wenzel-lab/SiMoRa-microscope/docs/laser "clamshell" part1.png

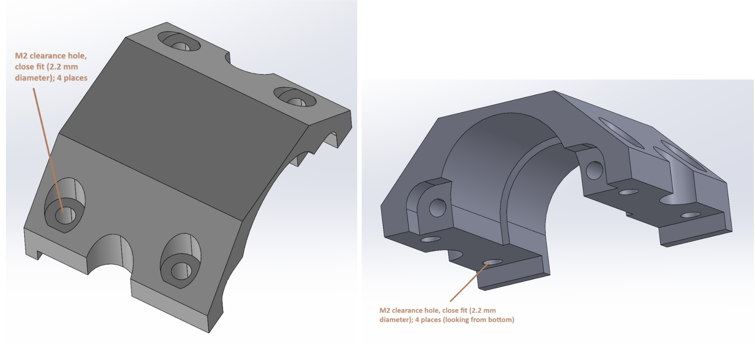
docs/laser "clamshell" part1.png
