wenzel-lab/SiMoRa-microscope/docs/laser "clamshell" part2.png

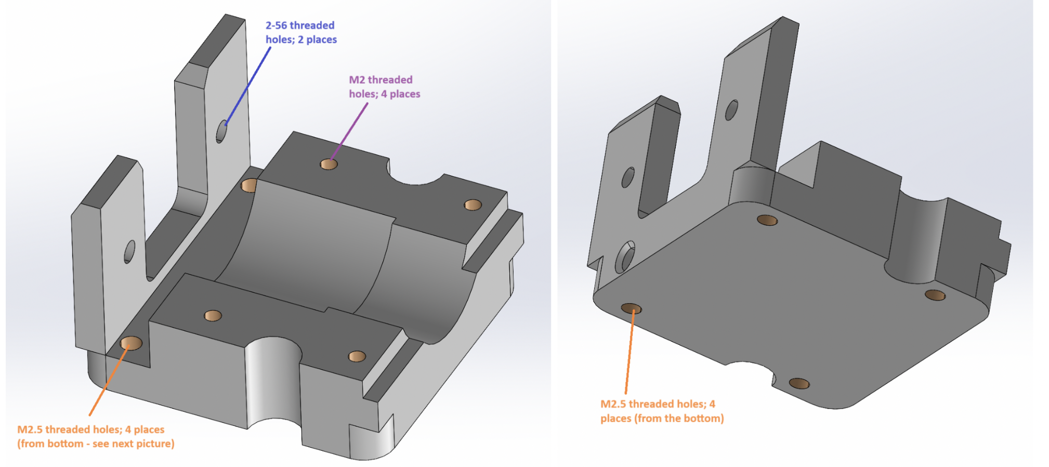
docs/laser "clamshell" part2.png
