wenzel-lab/SiMoRa-microscope/images/fan-controller-board.jpeg

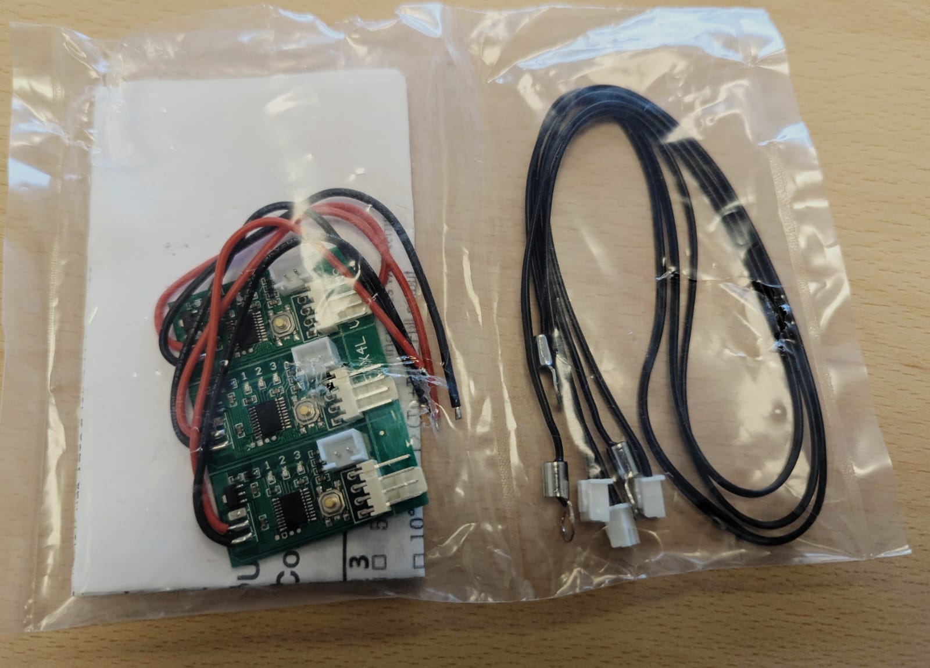
images/fan-controller-board.jpeg
