wenzel-lab/SiMoRa-microscope/images/filter_orientations.jpeg

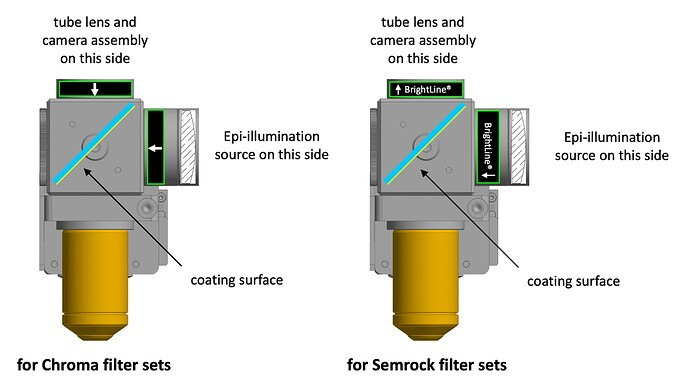
images/filter_orientations.jpeg
