wenzel-lab/SiMoRa-microscope/images/SQUID-4x5chanel-fluorescence-microscope V2.jpeg

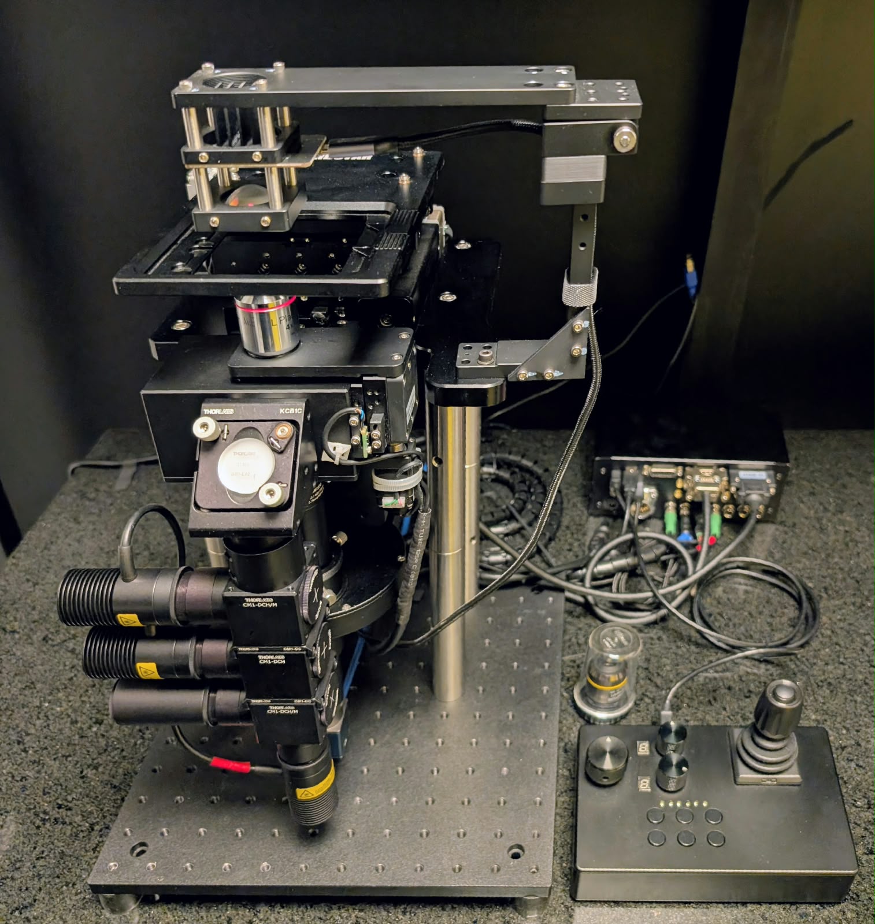
images/SQUID-4x5chanel-fluorescence-microscope V2.jpeg
