wenzel-lab/SiMoRa-microscope/docs/fan_controller_instructions.pdf

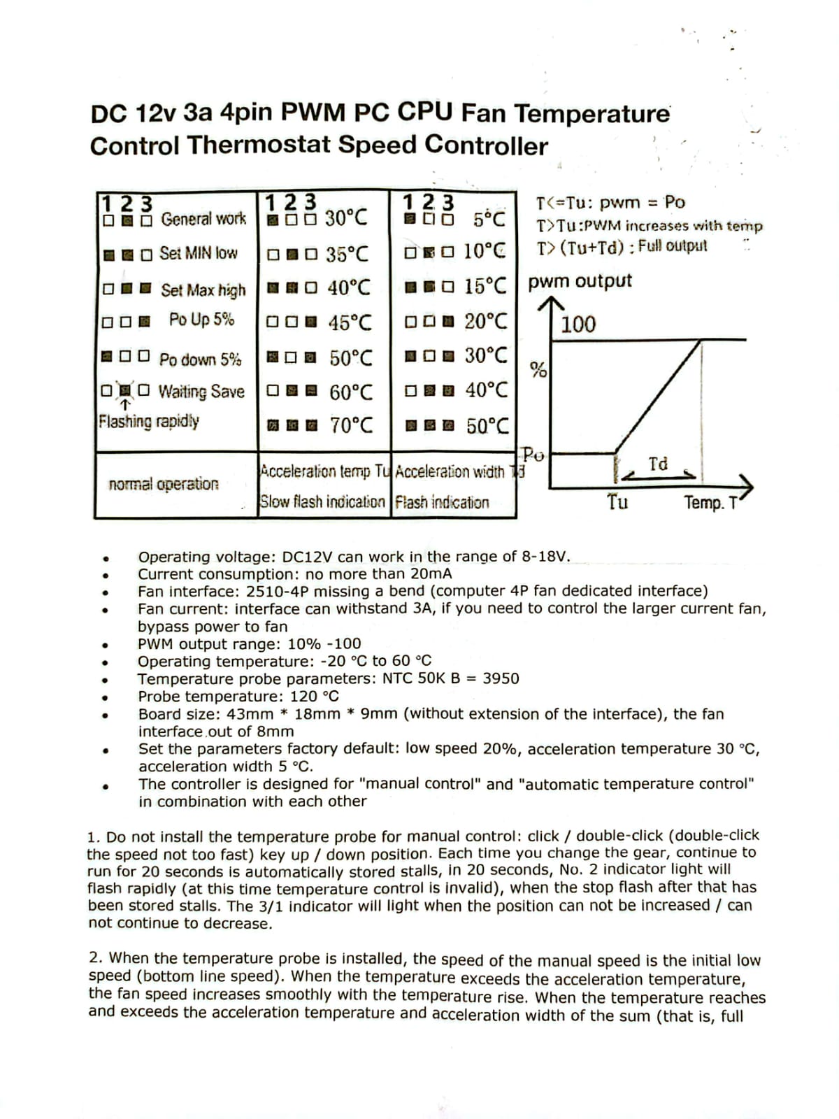
[picture p14: page 1]
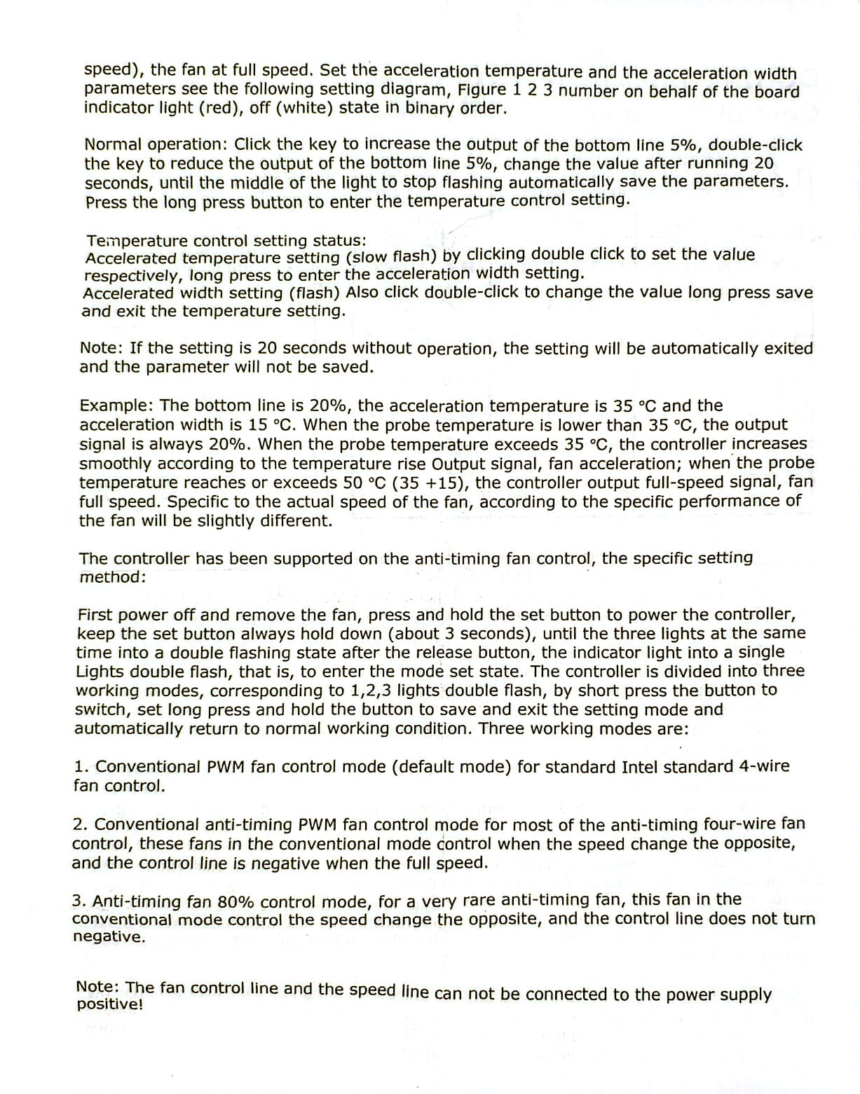
[picture p15: page 2]
