wenzel-lab/SiMoRa-microscope/docs/Squid_controller PCB.pdf

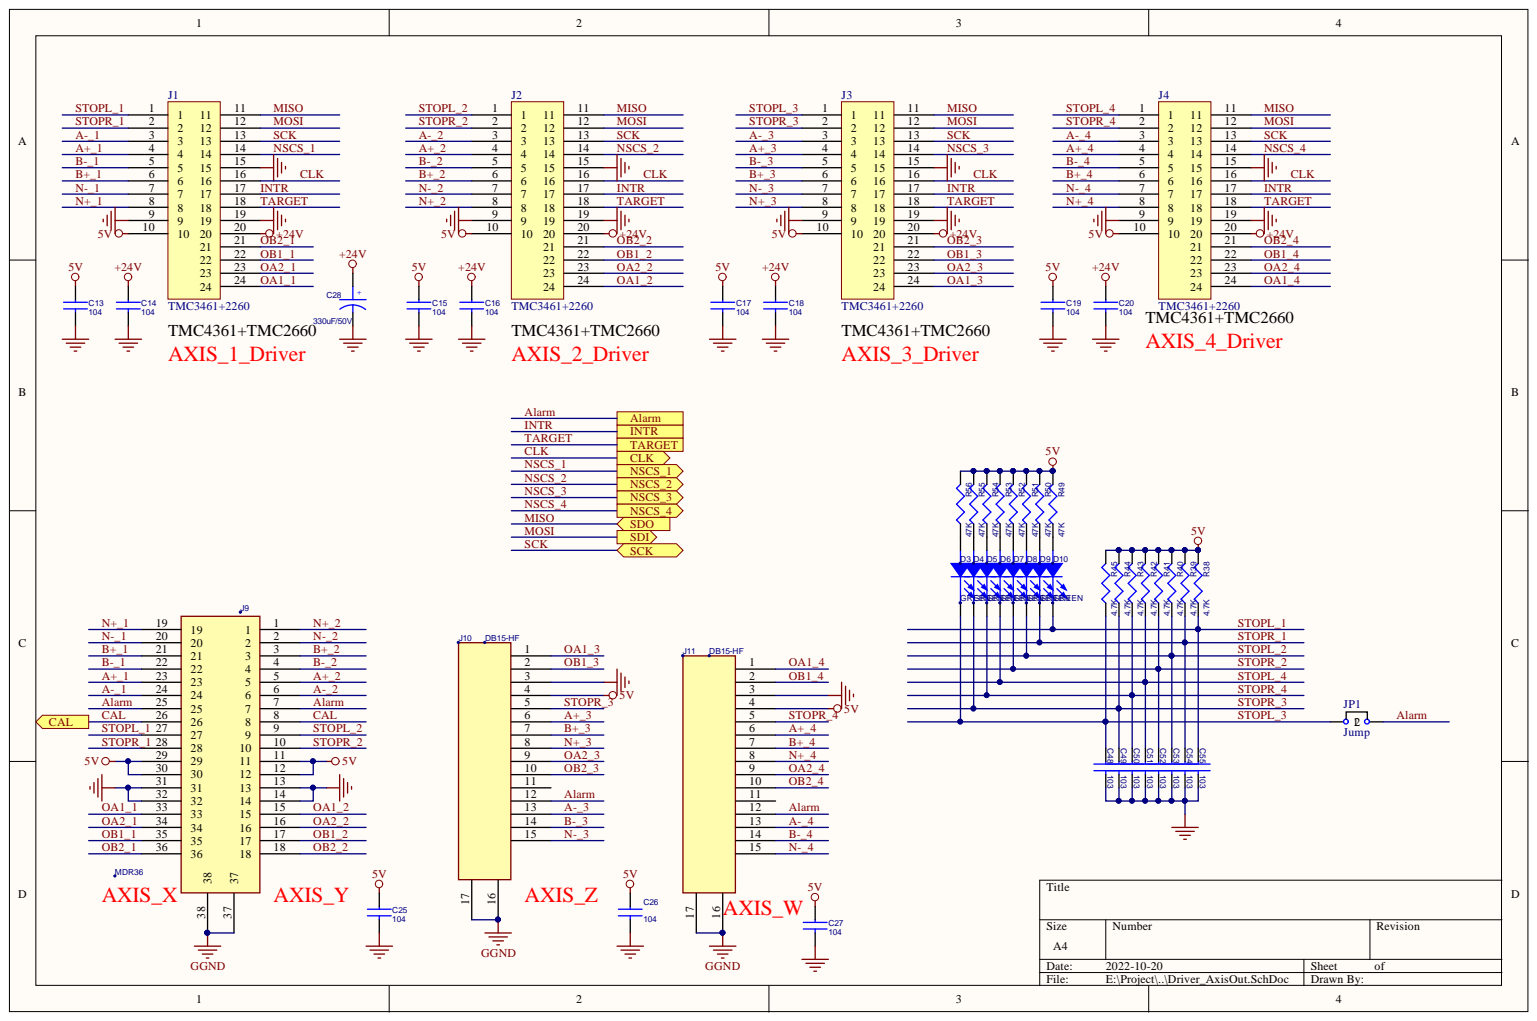
[picture p16: page 1]

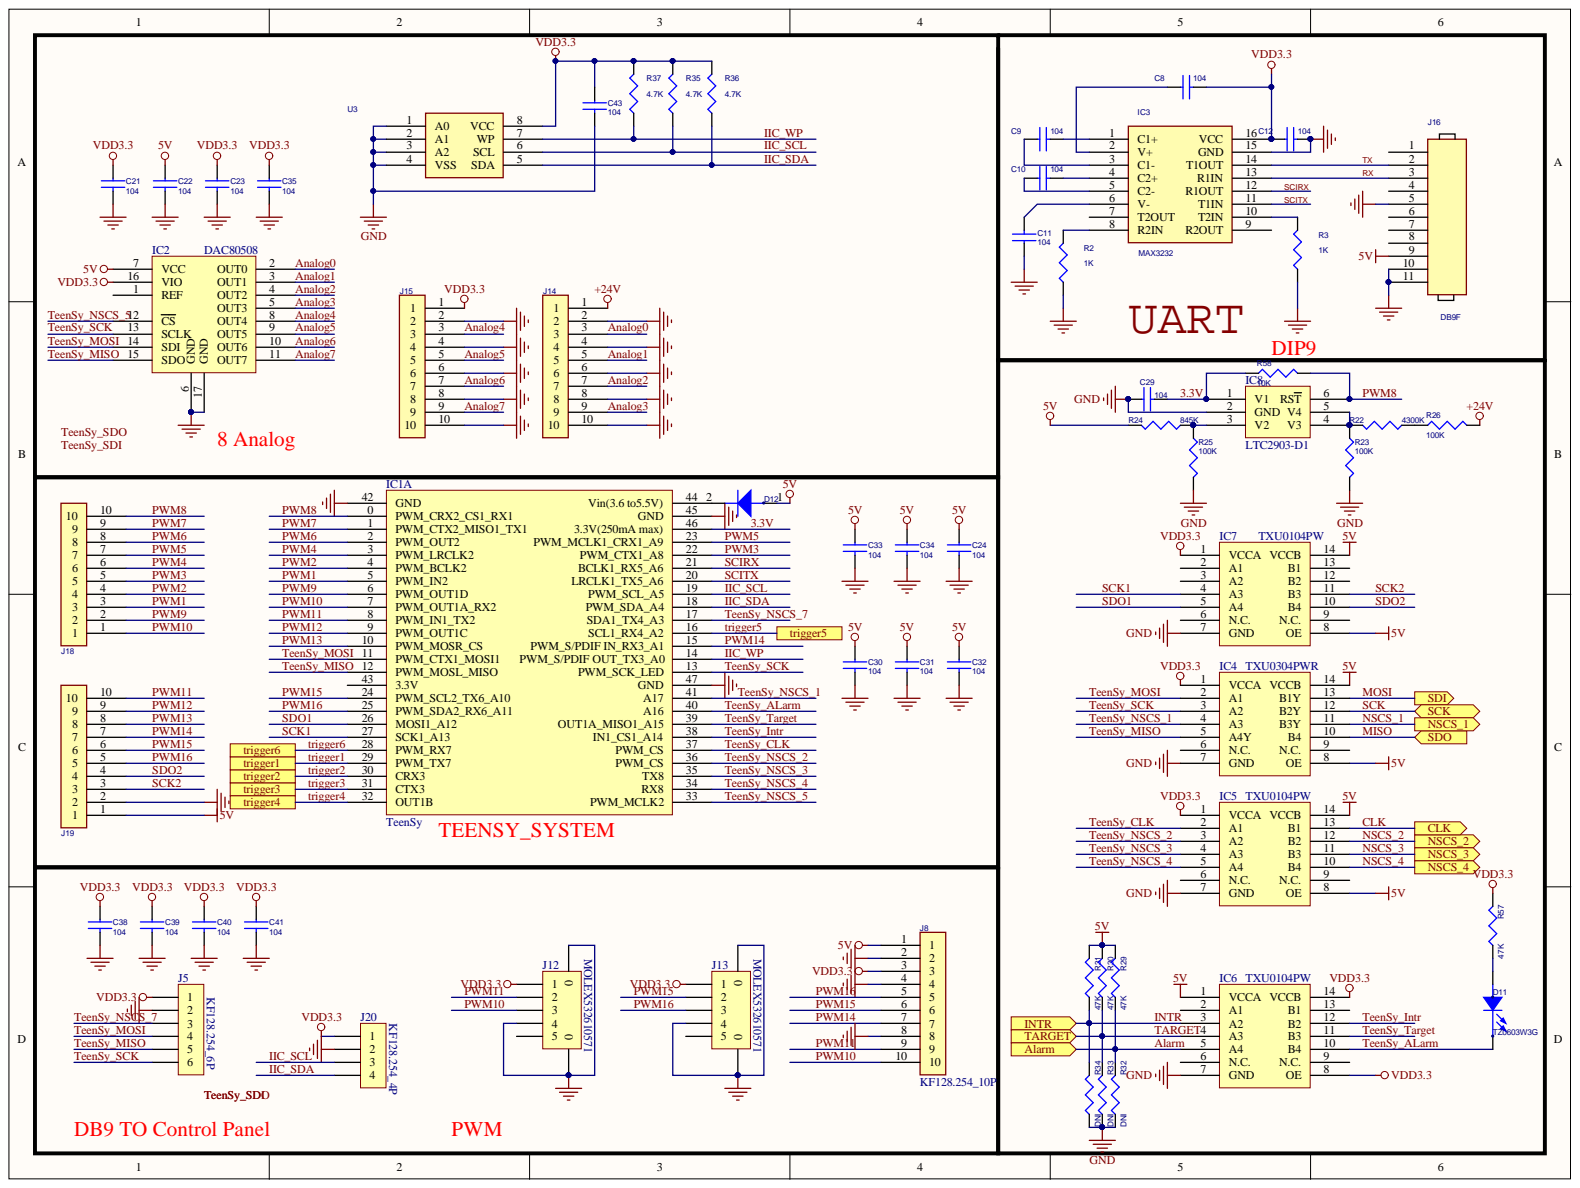
[picture p17: page 2]

V- 6 | 5
T2OUT 7 | 6

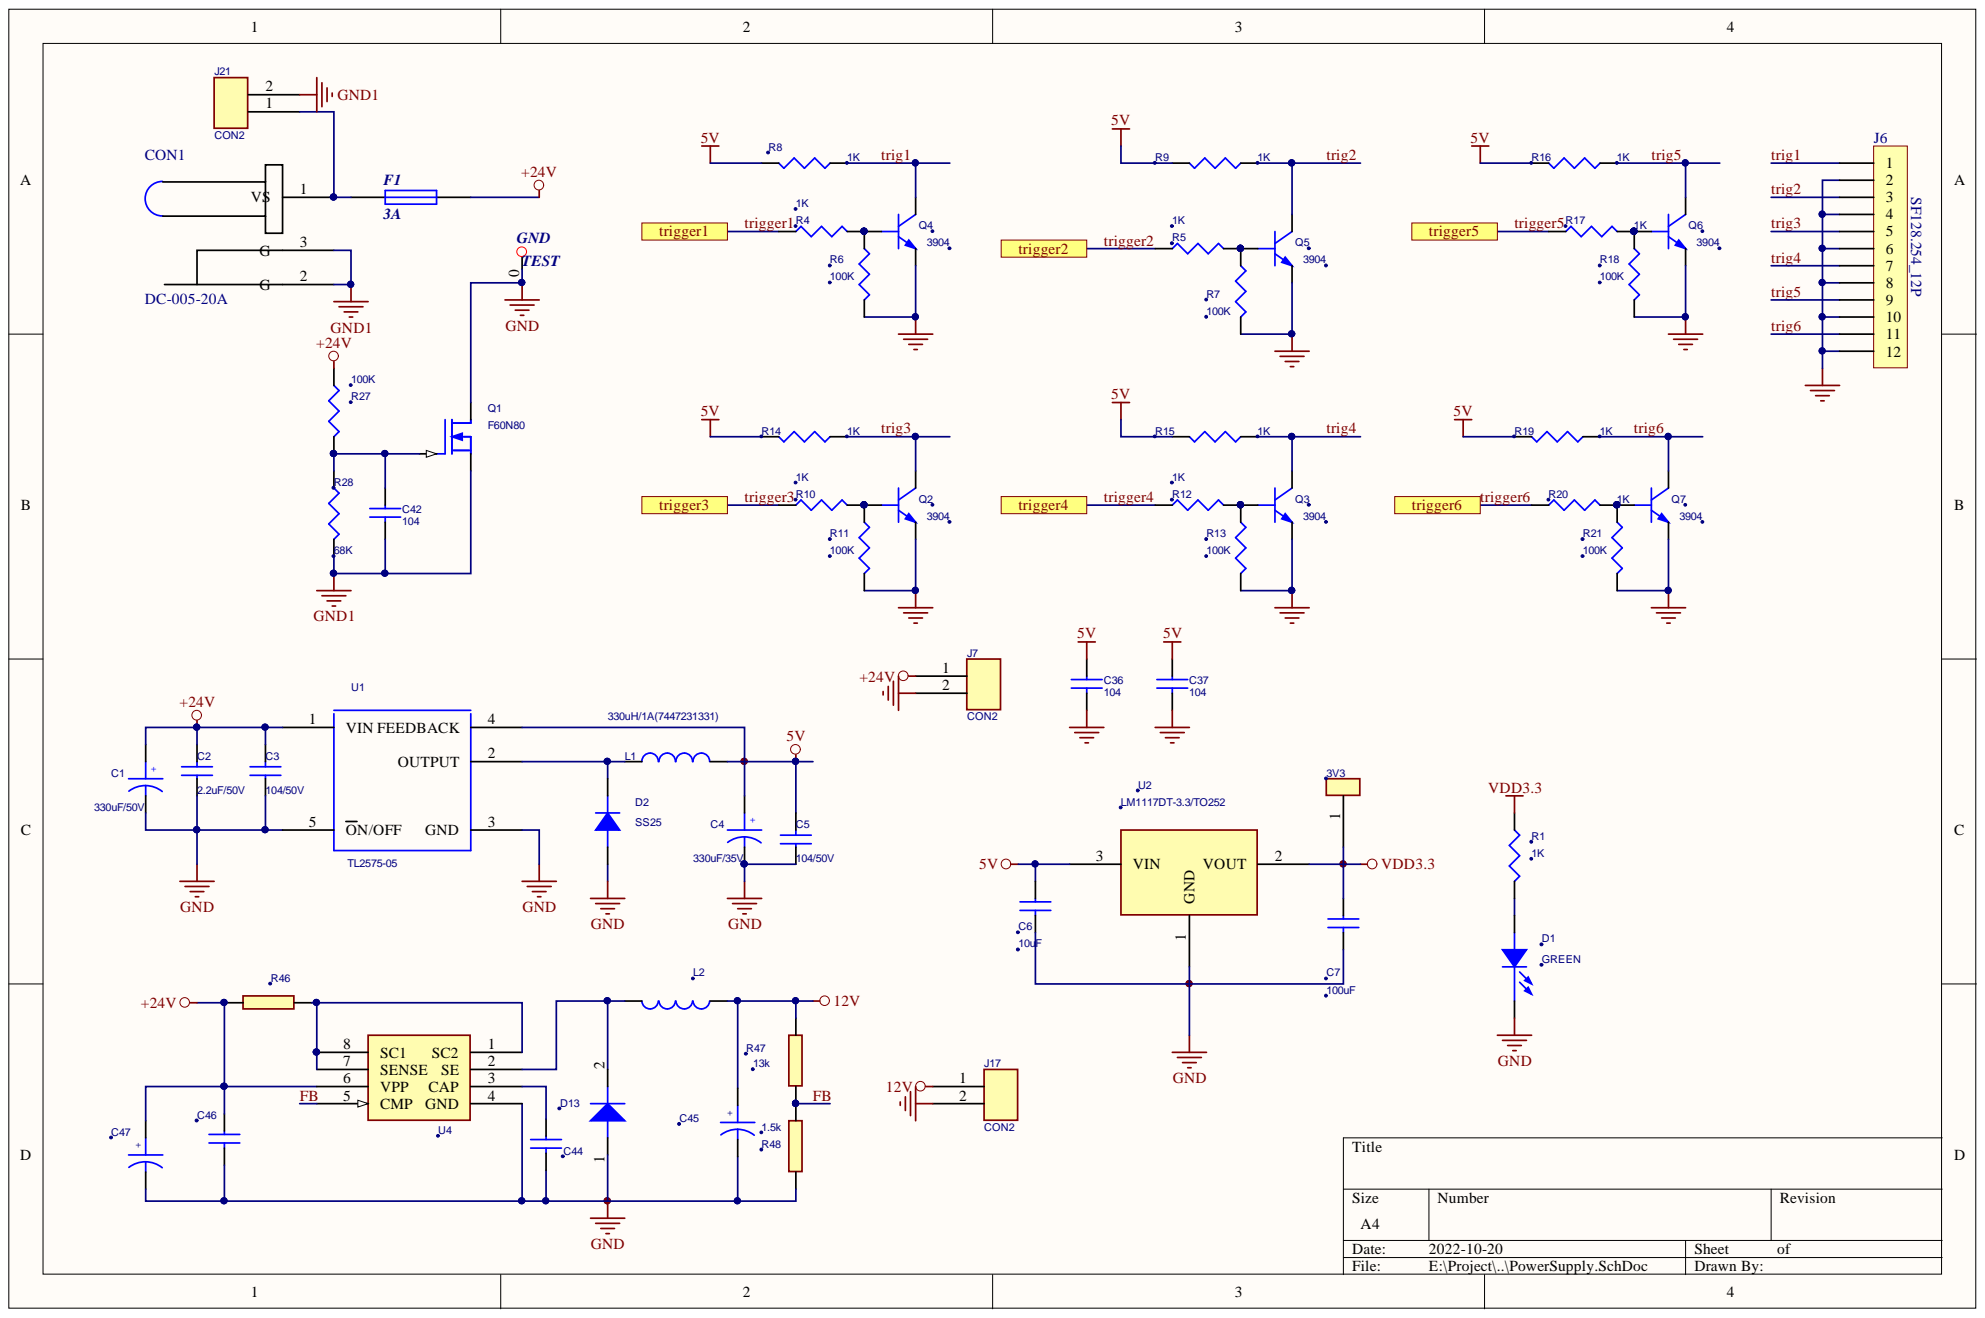
[picture p18: page 3]

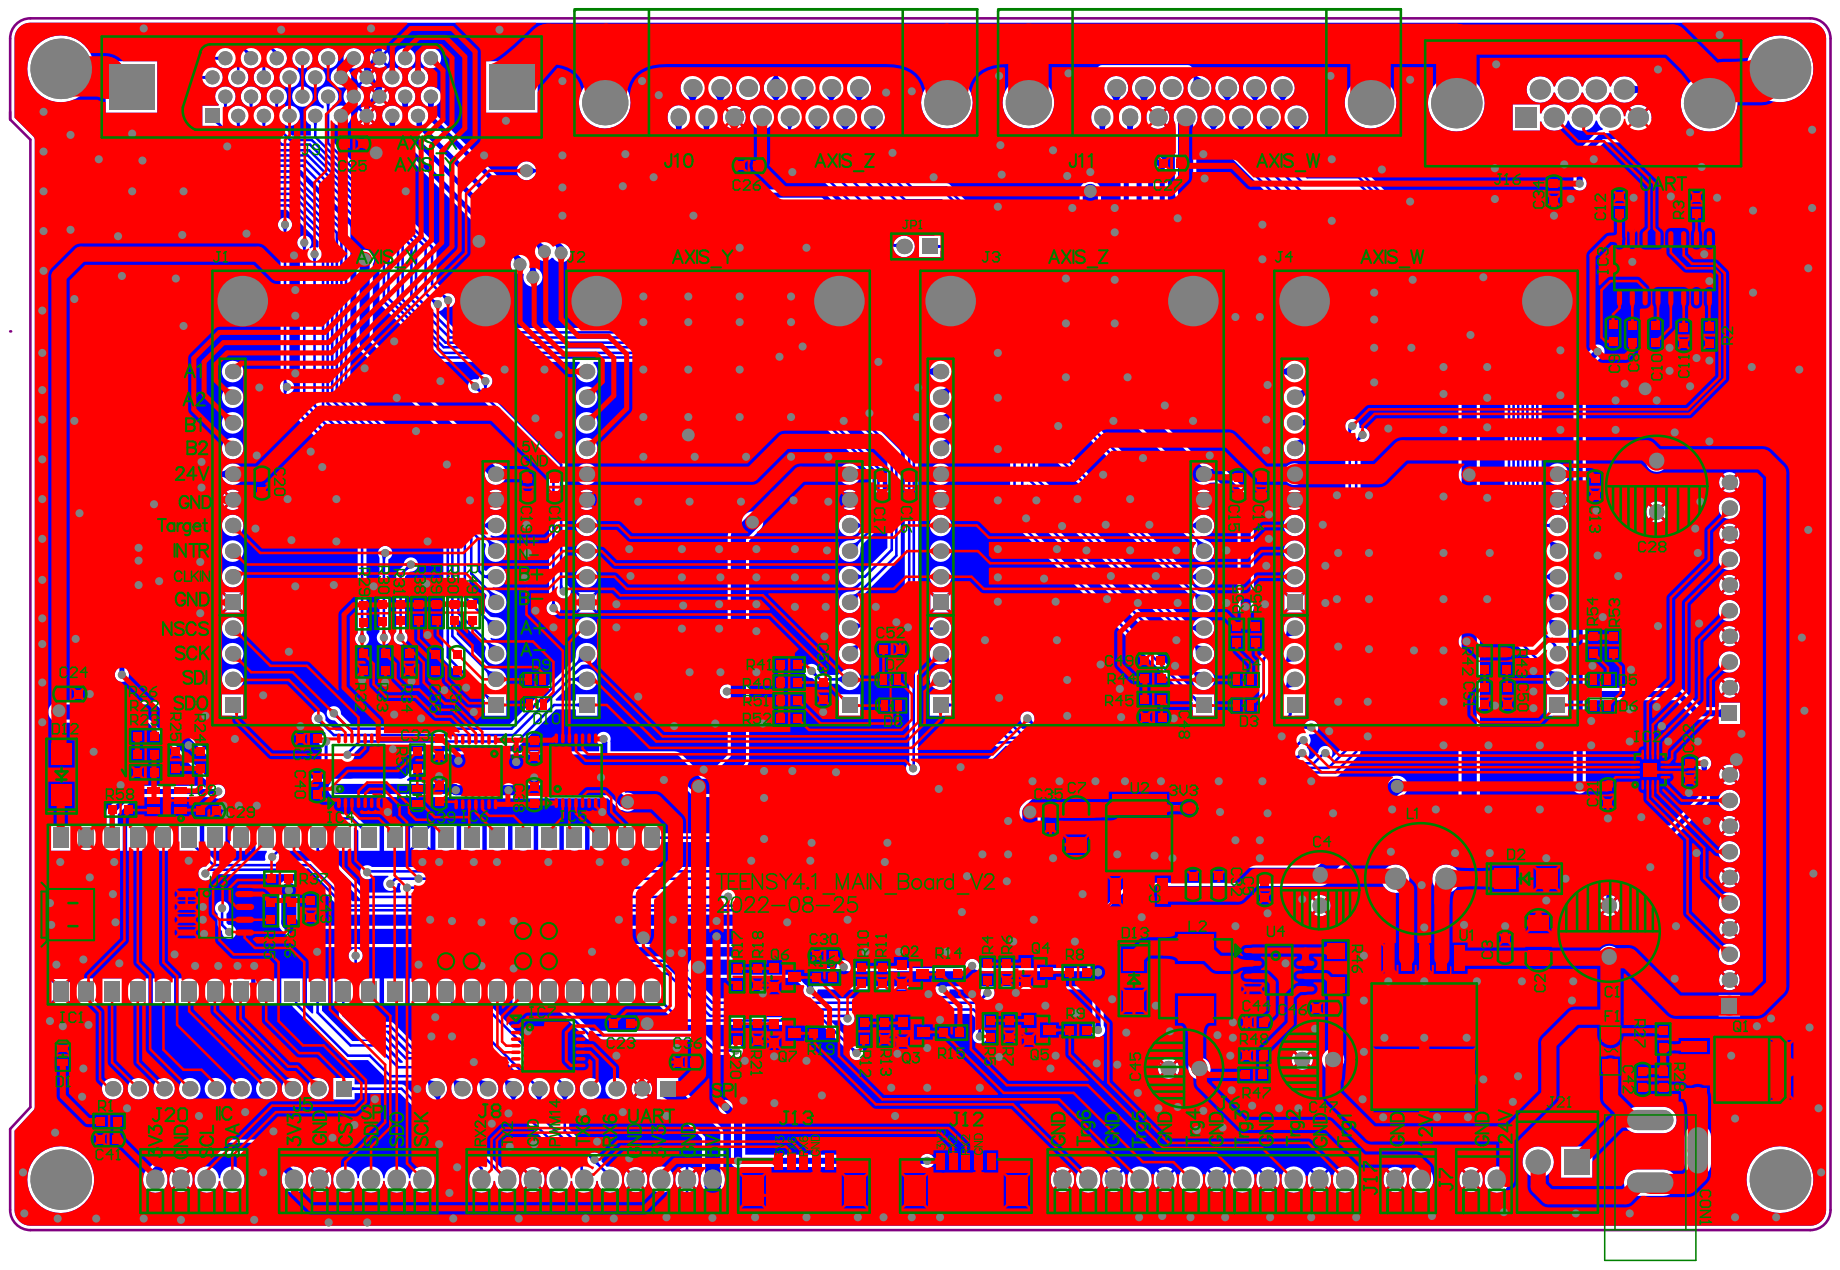
[picture p19: page 4]
