wenzel-lab/SiMoRa-microscope/(commit log)

2025-04-01 Update README.md
    with Raman bill of materials
2025-05-17 Update README.md
    Add user driver configuration instructions and answered questions.
2025-05-19 Create Squid_controller PCB.pdf
2025-08-09 add schematic and images
2025-08-11 update schematic with letters
2025-08-11 update schematic
2025-08-12 add LED spec docs
2025-08-12 Update README.md
    add additional Raman blocking filter information
2025-09-03 Add readme for IDS U3-38C0XCP-M-NO camera setup
    Added instructions for installing and using the IDS U3-38C0XCP-M-NO camera on Ubuntu, including SDK installation and Squid GUI setup.
2025-09-03 add specification sheet for cable
2025-10-30 Update LED information in README.md
